el-bart/TIGER/doc/todo.txt

* describe protocol to be used for communication.
