el-bart/TIGER/rt_board/hw/rt_board.brd

## EAGLE design rt_board/hw/rt_board.brd (2014-01-15)

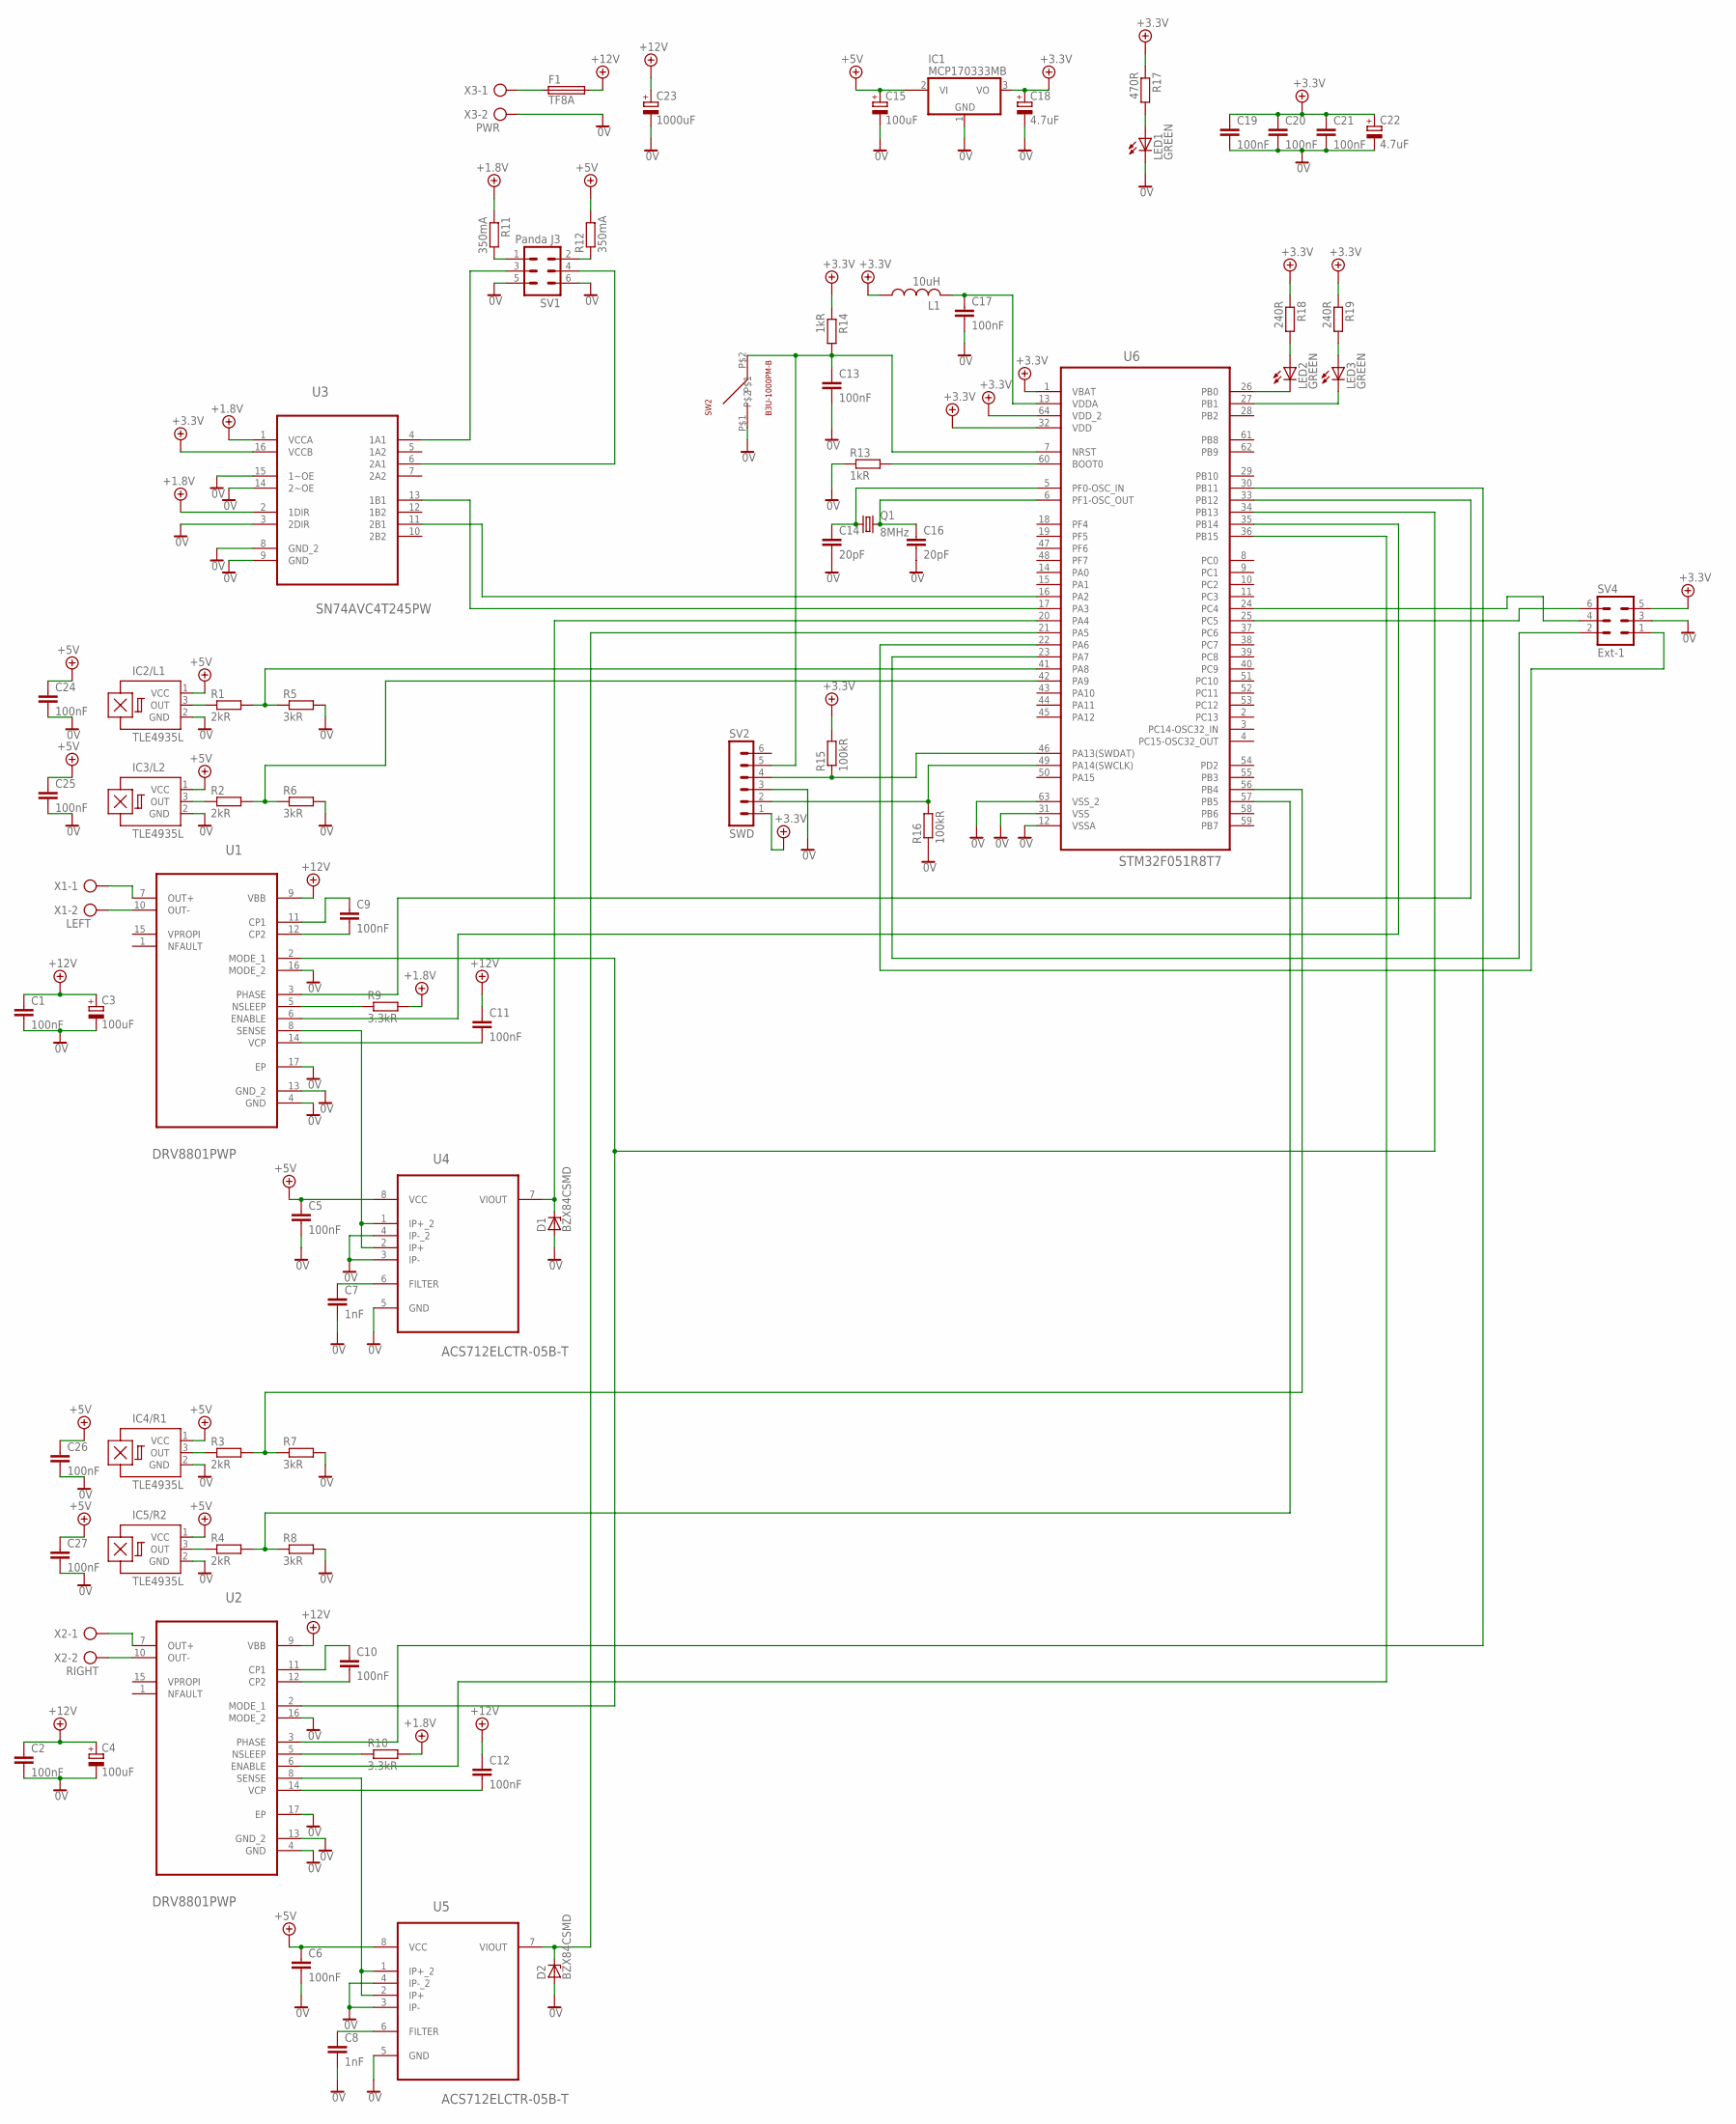
[picture p1: schematic rt_board.sch]

Parts:
C1, C2, C5, C6, C9, C10, C11, C12, C13, C17, C19, C20, C21, C24, C25, C26, C27: 100nF; C1206
C3, C4: 100uF; 153CLV-0810
C7, C8: 1nF; C1206
C14, C16: 20pF; C0603
C15: 100uF; 153CLV-0605
C18, C22: 4.7uF; 153CLV-0405
C23: 1000uF; 153CLV-1014
D1, D2: BZX84CSMD; TO236
F1: TF8A; SH22
IC1: MCP170333MB; SOT89
IC2/L1, IC3/L2, IC4/R1, IC5/R2: TLE4935L; SIP3-UA
L1: 10uH; L2012C
LED1, LED2, LED3: GREEN; CHIPLED_0603
Q1: 8MHz; MC-405
R1, R2, R3, R4: 2kR; R0603
R5, R6, R7, R8: 3kR; R0603
R9, R10: 3.3kR; R0603
R11, R12: 350mA; MINI_MELF-0204W
R13, R14: 1kR; R0603
R15, R16: 100kR; R0603
R17: 470R; R0603
R18, R19: 240R; R0603
SV1: Panda J3; MA03-2
SV2: SWD; MA06-1
SV4: Ext-1; MA03-2
SW2: B3U-1000PM-B; SPST-NO
U1, U2: DRV8801PWP; SOP65P640X120-17N
U3: SN74AVC4T245PW; SOP65P640X120-16N
U4, U5: ACS712ELCTR-05B-T; SOIC127P600X175-8N
U6: STM32F051R8T7; QFP50P1200X1200X160-64N
X1: LEFT; AK300/2
X2: RIGHT; AK300/2
X3: PWR; AK300/2

Connections:
0V: C1.2, C2.2, C3.-, C4.-, C5.2, C6.2, C7.2, C8.2, C13.2, C14.2, C15.-, C16.2, C17.2, C18.-, C19.2, C20.2, C21.2, C22.-, C23.-, C24.2, C25.2, C26.2, C27.2, D1.A, D2.A, IC1.1 (GND), IC2/L1.2 (GND), IC3/L2.2 (GND), IC4/R1.2 (GND), IC5/R2.2 (GND), LED1.C, R5.2, R6.2, R7.2, R8.2, R13.1, R16.1, SV1.5, SV1.6, SV2.3, SV4.3, SW2.P$1, U1.4 (GND), U1.13 (GND_2), U1.16 (MODE_2), U1.17 (EP), U2.4 (GND), U2.13 (GND_2), U2.16 (MODE_2), U2.17 (EP), U3.3 (2DIR), U3.8 (GND_2), U3.9 (GND), U3.14 (2~OE), U3.15 (1~OE), U4.3 (IP-), U4.4 (IP-_2), U4.5 (GND), U5.3 (IP-), U5.4 (IP-_2), U5.5 (GND), U6.12 (VSSA), U6.31 (VSS), U6.63 (VSS_2), X3.2
+5V: C18.+, C19.1, C20.1, C21.1, C22.+, IC1.3 (VO), L1.1, R14.1, R15.2, R17.1, R18.1, R19.1, SV2.1, SV4.5, U3.16 (VCCB), U6.1 (VBAT), U6.32 (VDD), U6.64 (VDD_2)
+5V/1: C5.1, C6.1, C15.+, C24.1, C25.1, C26.1, C27.1, IC1.2@1 (VI1), IC2/L1.1 (VCC), IC3/L2.1 (VCC), IC4/R1.1 (VCC), IC5/R2.1 (VCC), R12.2, U4.8 (VCC), U5.8 (VCC)
+5V/4: R9.2, R10.2, R11.1, U3.1 (VCCA), U3.2 (1DIR)
+12V: C1.1, C2.1, C3.+, C4.+, C11.1, C12.1, C23.+, F1.2, U1.9 (VBB), U2.9 (VBB)
unnamed: LED2.C, U6.26 (PB0)
unnamed: F1.1, X3.1
unnamed: C17.1, L1.2, U6.13 (VDDA)
unnamed: R16.2, SV2.2, U6.49 (PA14(SWCLK))
unnamed: R13.2, U6.60 (BOOT0)
unnamed: C13.1, R14.2, SV2.5, SW2.P$2, U6.7 (NRST)
unnamed: C14.1, Q1.1, U6.5 (PF0-OSC_IN)
unnamed: C16.1, Q1.2, U6.6 (PF1-OSC_OUT)
unnamed: R15.1, SV2.4, U6.46 (PA13(SWDAT))
unnamed: R12.1, SV1.2
unnamed: R11.2, SV1.1
unnamed: SV1.3, U3.4 (1A1)
unnamed: U3.13 (1B1), U6.17 (PA3)
unnamed: U3.11 (2B1), U6.16 (PA2)
unnamed: SV1.4, U3.6 (2A1)
unnamed: IC2/L1.3 (OUT), R1.1
unnamed: R1.2, R5.1, U6.41 (PA8)
unnamed: IC3/L2.3 (OUT), R2.1
unnamed: R2.2, R6.1, U6.42 (PA9)
unnamed: U1.7 (OUT+), X1.1
unnamed: U1.10 (OUT-), X1.2
unnamed: U1.8 (SENSE), U4.1 (IP+_2), U4.2 (IP+)
unnamed: D1.C, U4.7 (VIOUT), U6.20 (PA4)
unnamed: C7.1, U4.6 (FILTER)
unnamed: R9.1, U1.5 (NSLEEP)
unnamed: C11.2, U1.14 (VCP)
unnamed: C9.2, U1.12 (CP2)
unnamed: C9.1, U1.11 (CP1)
unnamed: IC4/R1.3 (OUT), R3.1
unnamed: R3.2, R7.1, U6.56 (PB4)
unnamed: IC5/R2.3 (OUT), R4.1
unnamed: R4.2, R8.1, U6.57 (PB5)
unnamed: U2.7 (OUT+), X2.1
unnamed: U2.10 (OUT-), X2.2
unnamed: C8.1, U5.6 (FILTER)
unnamed: U2.8 (SENSE), U5.1 (IP+_2), U5.2 (IP+)
unnamed: D2.C, U5.7 (VIOUT), U6.21 (PA5)
unnamed: R10.1, U2.5 (NSLEEP)
unnamed: C12.2, U2.14 (VCP)
unnamed: C10.2, U2.12 (CP2)
unnamed: C10.1, U2.11 (CP1)
unnamed: U1.2 (MODE_1), U2.2 (MODE_1), U6.34 (PB13)
unnamed: LED1.A, R17.2
unnamed: LED2.A, R18.2
unnamed: U1.6 (ENABLE), U6.35 (PB14)
unnamed: U2.6 (ENABLE), U6.36 (PB15)
unnamed: LED3.C, U6.27 (PB1)
unnamed: U1.3 (PHASE), U6.33 (PB12)
unnamed: U2.3 (PHASE), U6.30 (PB11)
unnamed: LED3.A, R19.2
unnamed: SV4.6, U6.25 (PC5)
unnamed: SV4.4, U6.24 (PC4)
unnamed: SV4.2, U6.23 (PA7)
unnamed: SV4.1, U6.22 (PA6)

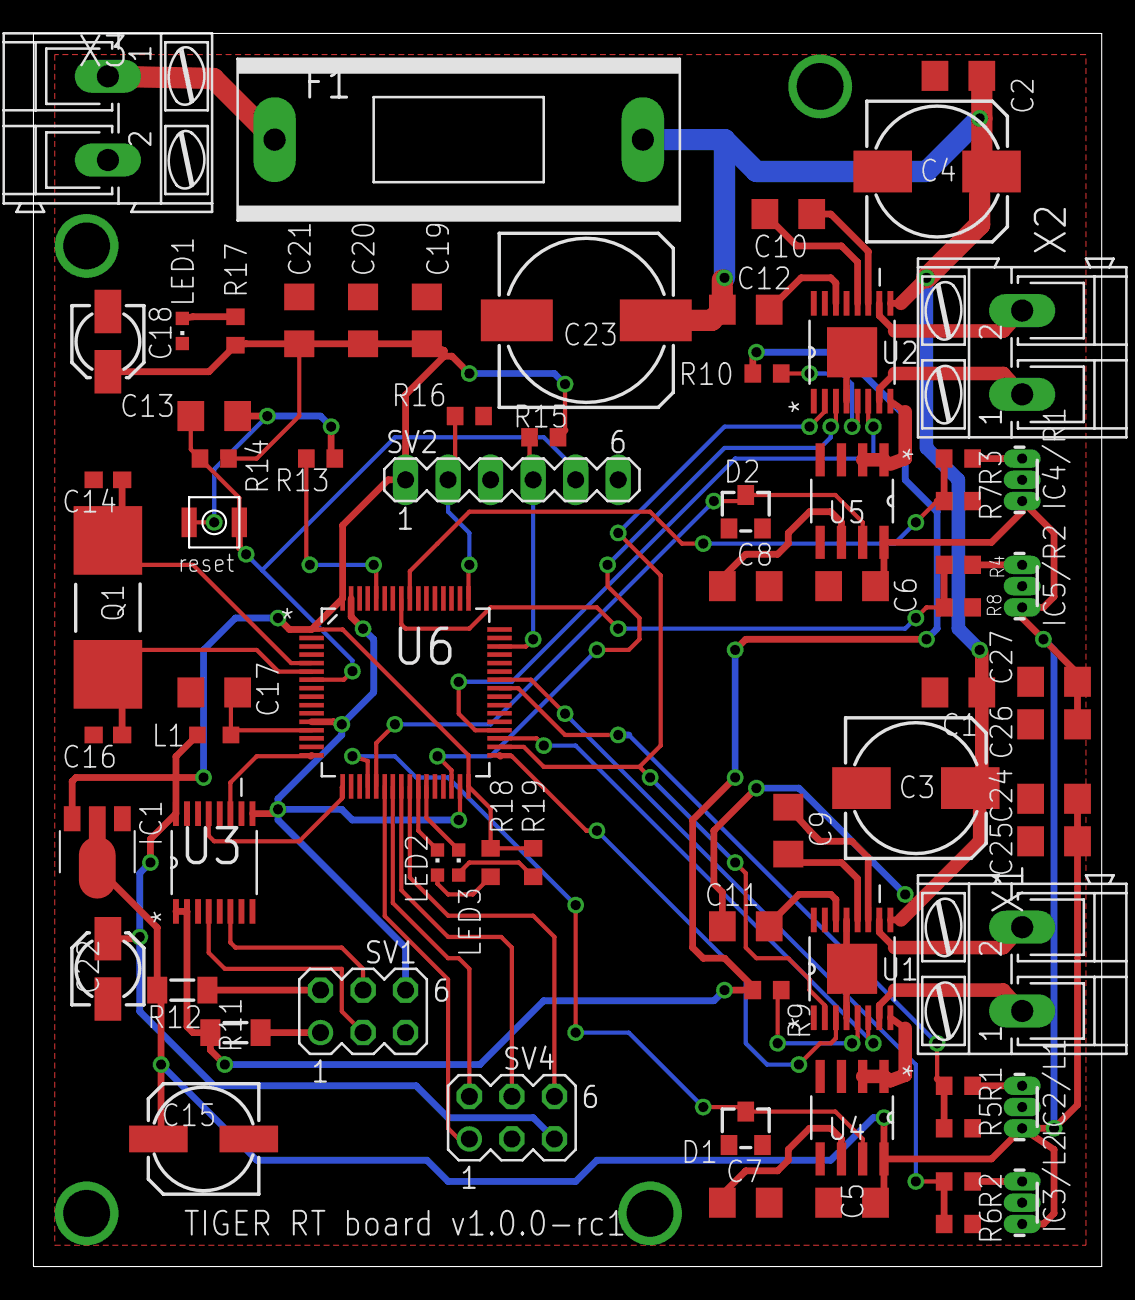
[picture p2: board rt_board.brd from above]

Board: 2 copper layers, 63.8 x 73.7 mm, 72 parts (0 on the bottom side), 59 nets.
