el-bart/TIGER/(commit log)

2009-10-30 files from old repos.
    added:
    motors_controler/
    motors_controler/Makefile
    motors_controler/config.h
    motors_controler/motors_control.c
    motors_controler/uC_used.txt
    rt_ctl/
    rt_ctl/rt_ctl.brd
    rt_ctl/rt_ctl.sch
    [rt_ctl.brd, rt_ctl.sch]
2009-12-10 documentation directory arranged.
    doc/
    doc/current@
    doc/specs/
    doc/specs/attiny3213v.pdf
    doc/v0.1.0/
    renamed:
    motors_controler/uC_used.txt => doc/v0.1.0/uC_used.txt
    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
2009-12-11 links to helper materials and tutorials on PWM, watchdog, EEPROM, etc...
    doc/specs/materials.txt
    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
2009-12-12 renamed: doc/specs/materials.txt => doc/materials.txt
2009-12-12 added: doc/common/ renamed: doc/materials.txt => doc/common/materials.txt doc/shops.txt => doc/common/shops.txt doc/specs/ => doc/common/specs/ doc/tank_parameters/ => doc/common/tank_parameters/
2009-12-12 switched to Texas Instrument datasheet.
    modified:
    doc/common/specs/max232.pdf
2009-12-12 switched from max639 to clasic stabilizer, since its ~100 times cheaper.
    removed:
    doc/common/specs/max639.pdf
    doc/common/specs/lm7805.pdf
    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
2009-12-12 project's work in progress.
    rt_ctl/rt_ctl.pro
    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
    [rt_ctl.brd, rt_ctl.sch]
2009-12-12 RS232, uC, power are ready; motor control is partially done.
    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
    [rt_ctl.brd, rt_ctl.sch]
2009-12-13 elements slightly reorganized. added +9V route manually to enusre it's thick enought.
    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
    [rt_ctl.brd, rt_ctl.sch]
2009-12-13 create separate board for directo motor's power controll - it was too complicated on single-layer board with uC and communication protocols.
    eka/
    eka/motors_ctrl/
    eka/motors_ctrl/motors_ctrl.brd
    eka/motors_ctrl/motors_ctrl.sch
    rt_ctl/ => eka/controller/
    eka/controller/rt_ctl.brd
    eka/controller/rt_ctl.sch
    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
    [motors_ctrl.brd, motors_ctrl.sch, rt_ctl.brd, rt_ctl.sch]
2009-12-20 added SPI and connector to engines power controll.
    eka/controller/rt_ctl.pro
    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
    [rt_ctl.brd, rt_ctl.sch]
2009-12-20 added GND polygon.
    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
    [rt_ctl.brd]
2009-12-20 looks like final version for now.
    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
    [rt_ctl.brd, rt_ctl.sch]
2010-06-26 updated schematics and boards for rates counting mechanism. work in progress...
    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
    [motors_ctrl.brd, motors_ctrl.sch, rt_ctl.brd, rt_ctl.sch]
2010-06-27 work in progress.
    eka/motors_power_output/motors_ctrl.pro
    eka/motors_speed_reader/
    eka/motors_speed_reader/motors_ctrl.brd
    eka/motors_speed_reader/motors_ctrl.sch
    eka/motors_ctrl/ => eka/motors_power_output/
    eka/motors_power_output/motors_ctrl.brd
    eka/motors_power_output/motors_ctrl.sch
    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
    [motors_ctrl.brd, motors_ctrl.sch, rt_ctl.brd, rt_ctl.sch]
2010-07-04 sof tmoved to 'src' dir.
    src/
    src/uC/
    motors_controler/ => src/uC/motors_controler/
    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
2010-07-04 dir renamed to reflect its purpose better.
    eka/motors_power_output/ => eka/power_supply/
    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
    [motors_ctrl.brd, motors_ctrl.sch]
2010-07-04 temporary checkin.
    eka/power_supply/motors_ctrl.brd
    eka/power_supply/motors_ctrl.pro
    eka/power_supply/motors_ctrl.sch
    eka/power_supply/pwr_supply.brd
    eka/power_supply/pwr_supply.sch
    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
    [motors_ctrl.brd, motors_ctrl.sch, pwr_supply.brd, pwr_supply.sch]
2010-07-11 schema has been simplified.
    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
    [pwr_supply.brd, pwr_supply.sch]
2010-07-11 looks like placing everything on one board is too much for eagle...
    eka/rt_board/
    eka/rt_board/rt_board.brd
    eka/rt_board/rt_board.sch
    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
    [rt_board.brd, rt_board.sch]
2010-07-11 moving back to original solution.
    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
    [rt_board.brd, rt_board.sch]
2010-07-11 temporay checkin.
    eka/motors_speed_reader/motors_ctrl.pro
    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
    [motors_ctrl.brd]
2010-07-11 moving back to schematic with all on one board.
    eka/rt_board/rt_board.pro
    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
    [rt_board.brd, rt_board.sch]
2010-07-11 added output of schematics.
    eka/rt_board/export/
    eka/rt_board/export/bottom.png
    eka/rt_board/export/elements.png
    eka/rt_board/export/pads_vias.png
    eka/rt_board/export/top.png
    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
2010-07-11 board is (more less) done - still there is review to be done.
    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
    [rt_board.brd, rt_board.sch]
2010-07-11 fuse for uC and foto-barier changed to FF1A.
    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
    [rt_board.brd, rt_board.sch]
2010-07-11 added LED for power-on.
    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
    [rt_board.brd, rt_board.sch]
2010-07-11 removed previous projects for boards (single-sided).
    eka/controller/
    eka/power_supply/
    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
    [motors_ctrl.brd, motors_ctrl.sch, pwr_supply.brd, pwr_supply.sch, rt_ctl.brd, rt_ctl.sch]
2010-07-15 schema updated after review by Lukier.
    eka/rt_board/schema.png
    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
    [rt_board.brd, rt_board.sch]
2010-07-15 added CPU boards recommended by Lukier.
    doc/common/materials.txt
    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
2010-09-24 Makfile has been fixed for atmega8.
    src/uC/motors_controler/ => src/uC/rt_board/
    src/uC/rt_board/Makefile
    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
2010-09-24 renamed main and implemented simple LED turning on uppon uC start (to see if it works).
    src/uC/rt_board/motors_control.c => src/uC/rt_board/main.c
    src/uC/rt_board/main.c
    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
2010-11-18 fixed typos in code. implemented led-klinking.
    src/uC/rt_board/config.h
    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
2010-11-18 fixed marking of +/- on main power supply.
    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
    [rt_board.brd]
2010-11-18 fixed pin mapping.
    src/uC/rt_board/PIN_MAP.txt
    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
2010-11-18 fixed too small resistor for the output of the foto-barier.
    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
    [rt_board.brd, rt_board.sch]
2010-11-26 bugfix: added missing power connection to max232.
    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
    [rt_board.brd, rt_board.sch]
2010-11-26 fixed problem with two GND circuits.
    eka/BUGS
    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
    [rt_board.brd, rt_board.sch]
2010-11-26 input from foto-barier is now pin-head.
    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
    [rt_board.brd, rt_board.sch]
2010-11-26 added some space for radiator near lm7805 stabilizer.
    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
    [rt_board.brd]
2010-11-26 some small optimizations of routing and GND plates.
    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
    [rt_board.brd, rt_board.sch]
2010-12-04 configuration descriotion files.
    src/uC/rt_board/CONFIG.txt
    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
    [CONFIG.txt]
2011-02-12 removed extra dir uC/ from src/
    src/uC/rt_board/ => src/rt_board/
    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
    [CONFIG.txt]
2011-02-12 header guard fixed.
    src/rt_board/config.hpp
    src/rt_board/queue.hpp
    src/rt_board/uassert.hpp
    src/rt_board/usart.hpp
    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
    [config.hpp, uassert.hpp]
2011-02-12 includes fixed.
    src/rt_board/Queue.hpp
    src/rt_board/USART.cpp
    src/rt_board/uassert.cpp
    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
    [Queue.hpp, USART.cpp, uassert.cpp]
2011-02-12 impulse counting via interrupts have been developed and tested.
    src/rt_board/Impulses.cpp
    src/rt_board/main.cpp
    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
2011-02-24 PWM has been configured.
    src/rt_board/EngSpeed.cpp
    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
2011-02-24 doc/ dir structure sanitized.
    doc/common/
    doc/common/materials.txt => doc/materials.txt
    doc/common/shops.txt => doc/shops.txt
    doc/common/specs/ => doc/specs/
    doc/common/tank_parameters/ => doc/tank_parameters/
    doc/v0.1.0/RS232_CFG.txt => doc/RS232_CFG.txt
    doc/v0.1.0/RT_BOARD_PINS.txt => doc/RT_BOARD_PINS.txt
    doc/v0.1.0/uC_used.txt => doc/uC_used.txt
    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
2011-02-24 comments fixed.
    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
    [Impulses.cpp]
2011-02-24 engine speed has been reworked to have common API for left/right engine (static polymorphism).
    src/rt_board/EngSpeed.hpp
    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
    [EngSpeed.cpp, EngSpeed.hpp]
2011-02-24 speed sontrol draft is ready; it does not work as should yet (TODOs are present).
    src/rt_board/SpeedControl.cpp
    src/rt_board/SpeedControl.hpp
    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
    [SpeedControl.cpp, SpeedControl.hpp, main.cpp]
2011-04-15 TODO fixed (typo)
    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
    [USART.cpp]
2012-05-29 eka -> hw
    [rt_board.brd, rt_board.sch]
2012-08-07 cleanup and description
    [rs232_config.txt]
2012-08-24 dorectory structure cleanup + minor comments and changes
    [rs232_config.txt, rt_board.brd, rt_board.sch]
2012-08-24 Lockable and Queue basic threading facilities
2012-08-24 optical flow computation
2012-08-24 optical flow computation - TODO added
2013-12-10 added engine resistance and nominal voltage to docs
2013-12-10 TODOs added on motor controll
2013-12-10 todo added on RT board
2013-12-11 datasheets for RT-board updated
2013-12-16 datasheets update to reflect new devices in use
2013-12-16 first elements of new schema using STM32, FT232 and SMD in general
    [rt_board.brd, rt_board.sch]
2013-12-17 fixed SWD connection; added power VccIo to FT232
    [rt_board.brd, rt_board.sch]
2013-12-18 resigned from ft232 and USB communication in favor of direct communication with Panda's usart, via sn74avc4t245pw level converter
    [rt_board.brd, rt_board.sch]
2013-12-18 added power outputs and current control circutyr
    [rt_board.brd, rt_board.sch]
2013-12-18 pin descriptions updated
2013-12-18 added LED to indicate circut is powered and one user-defined, controlled via uC
    [rt_board.brd, rt_board.sch]
2013-12-18 fixed quartz location on schematic
    [rt_board.sch]
2013-12-18 TODOs for switches
2013-12-18 added boot0 and reset switches
    [rt_board.brd, rt_board.sch]
2013-12-18 changed quartz package
    [rt_board.brd, rt_board.sch]
2013-12-19 replaced ACS712ELCTR-20A-T with more acurate in a given range ACS712ELCTR-05B-T
    [rt_board.brd, rt_board.sch]
2013-12-20 first PCB/SMD version
    [rt_board.brd, rt_board.sch]
2013-12-20 minor fixes suggested by the tool
    [rt_board.brd, rt_board.sch]
2013-12-20 small track optimizations
    [rt_board.brd]
2013-12-20 main power routes thickened; montage drills are now connected to GND
    [rt_board.brd]
2013-12-20 board size optimized; added basic markings what is what
    [rt_board.brd]
2013-12-20 fixed and simplified user-defined LED-1 control
    [rt_board.brd, rt_board.sch]
2013-12-20 added user LED 2
    [rt_board.brd, rt_board.sch]
2013-12-20 fixed layout of names and values of devices, so that it is readable
    [rt_board.brd, rt_board.sch]
2013-12-20 added 1000uF to +12V input for extra decoupling
    [rt_board.brd, rt_board.sch]
2013-12-20 added 4x100nF for Hall sensors
    [rt_board.brd, rt_board.sch]
2013-12-20 replaced power connectors with the ones of an aproperiate size
    [rt_board.brd, rt_board.sch]
2013-12-20 slight elements replacement, so that more space around power connectors will be available
    [rt_board.brd]
2013-12-20 GND polygons are now allowed to have orphants
    [rt_board.brd]
2013-12-21 removed boot0 button; added 'reest' button decription
    [rt_board.brd, rt_board.sch]
2013-12-22 added Ext-1 pinhead with power supply and ground (4 gpios)
    [rt_board.brd, rt_board.sch]
2013-12-22 protection circutry will be added on the main power board (which is the one that will be constantly re-connected to power)
2013-12-22 signals connected to uC are now 0.01 instead of default 0.016, which caused routes to be too close to surrounding pins
    [rt_board.brd]
2013-12-22 minor readability improvements
    [rt_board.brd]
2014-01-15 moved drill off the power connector; fixed invalid GDB path cross with power supply
    [rt_board.brd]
2014-01-19 test application for checking if CPU is working (blinking LEDs)
